open-ephys/ephys-test-module-molex-504070-32-chan/README.md

# Test Module for Molex 504070-based Headstages

This test module works with the Open Ephys
[automated ephys tester](https://github.com/open-ephys/ephys-test-board). 
It can be used to verify the functionality of:

- ONIX Neuropixels 2.0 & Biosignal Headstage
