open-ephys/ephys-test-module-molex-504070-32-chan/eeprom/README.md

## Module EEPROM Programmer
This program can be run on the ephys-test-board when the
module is in to program its EEPROM.
