open-ephys/ephys-test-module-molex-504070-32-chan/pcb/ephys-test-module-molex-504070-32.kicad_pcb

## KiCad design pcb/ephys-test-module-molex-504070-32.kicad_pcb (2026-01-21)

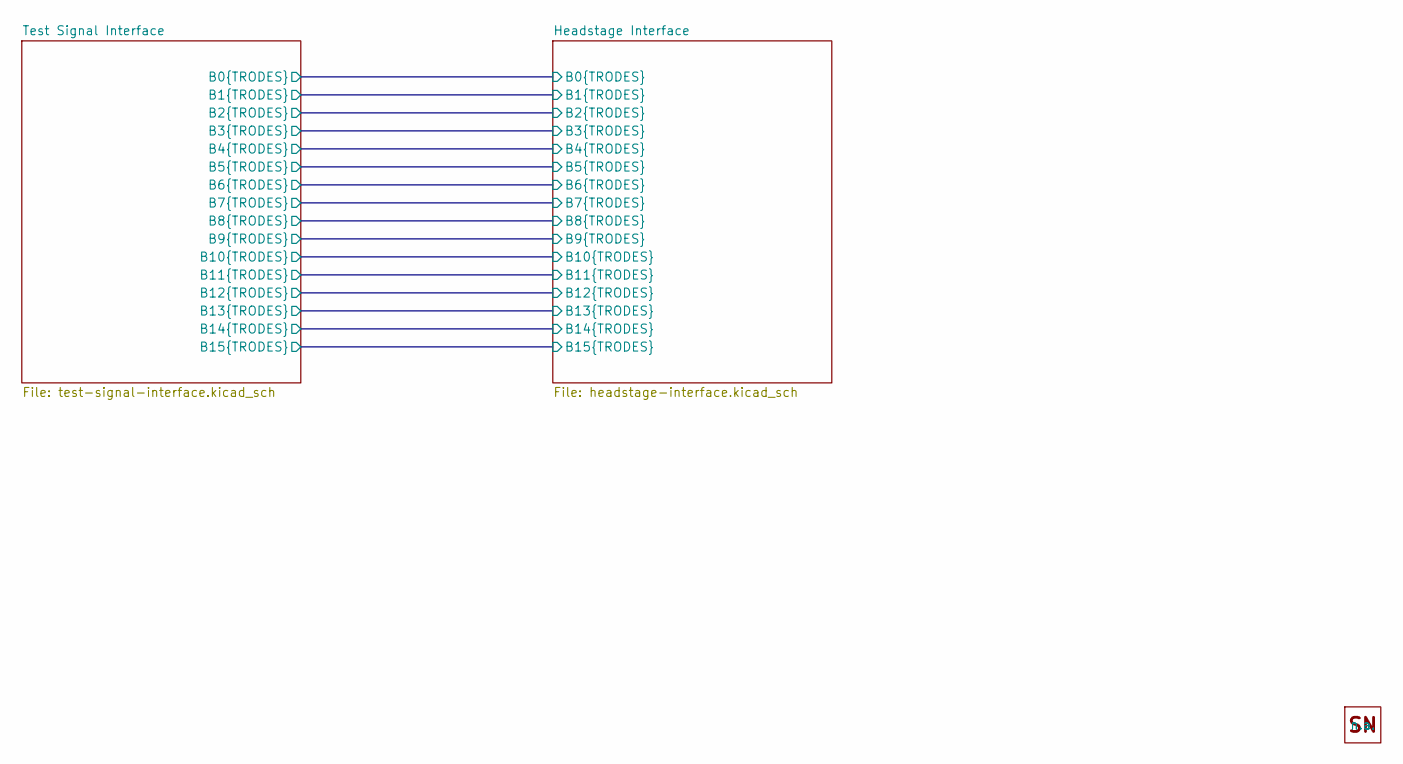
[picture p1: schematic ephys-test-module-molex-504070-32.kicad_sch, Ephys Test Module - 32 Channel (Molex 504070)]

Parts:
H1: OEPS_SN-STICKER-8x20mm; MPN n.a.

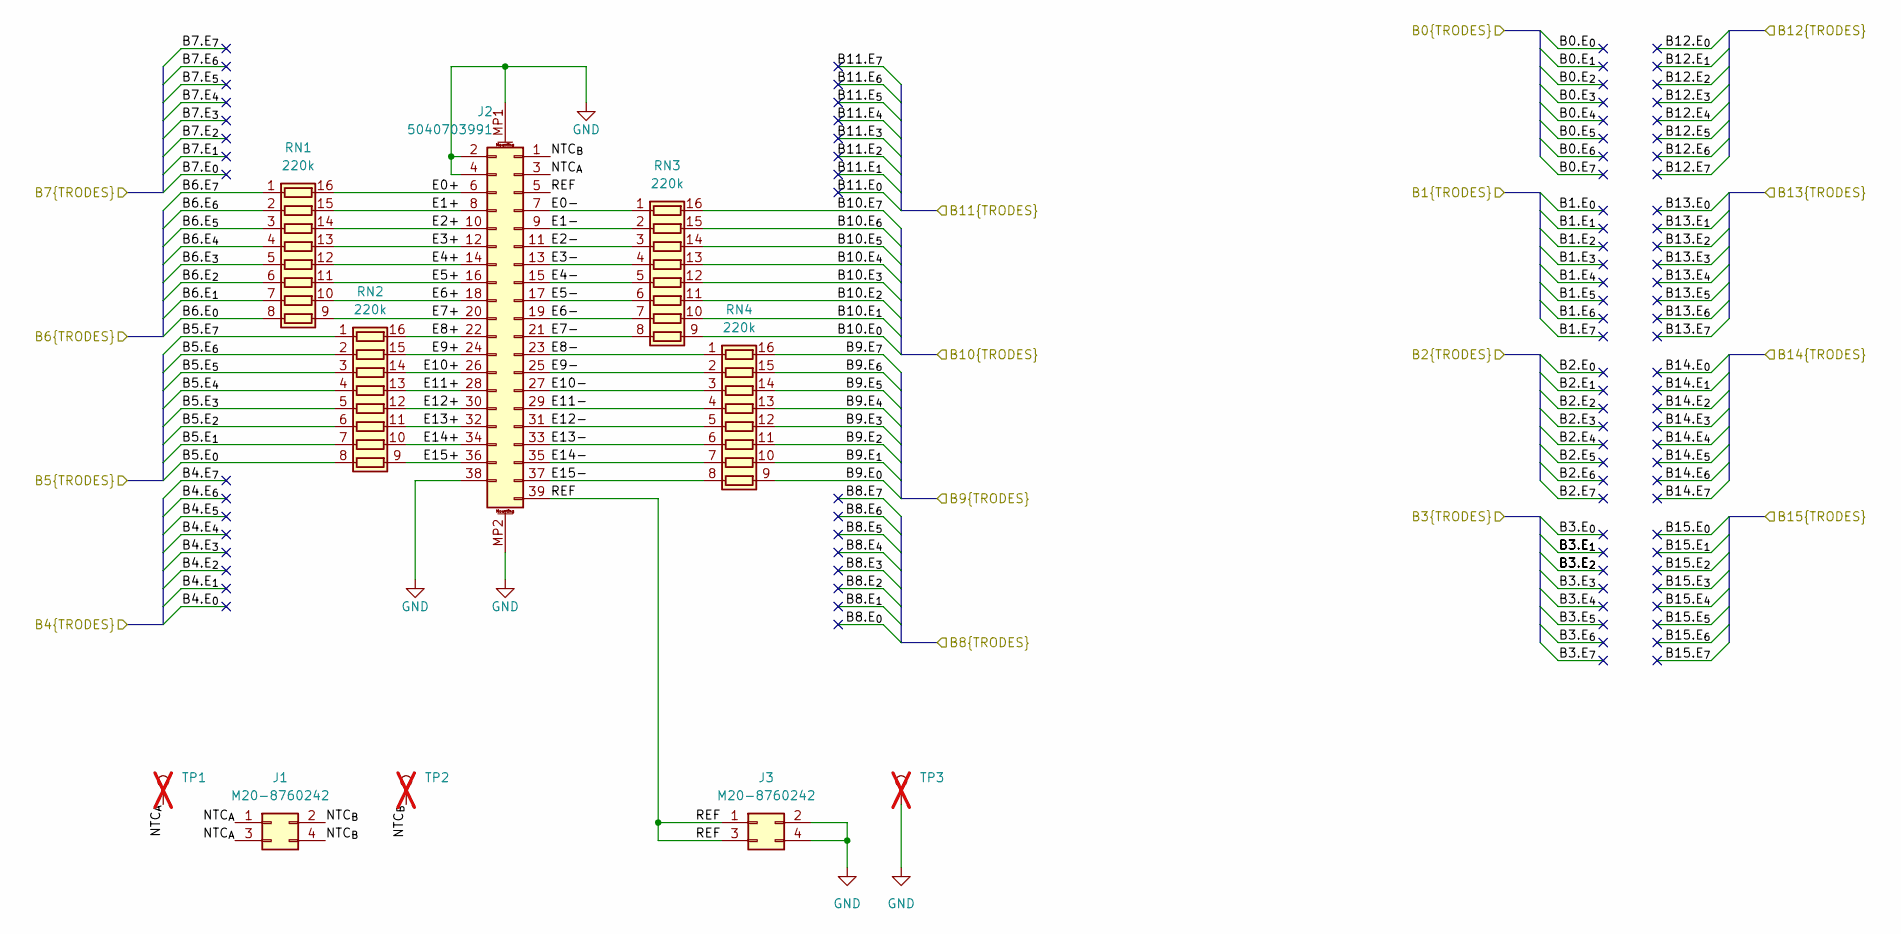
[picture p2: schematic headstage-interface.kicad_sch, Ephys Test Module - 32 Channel (Molex 504070)]

Parts:
J1, J3: M20-8760242; PinHeader_2x02_P2.54mm_Vertical_SMD; MPN M20-8760242
J2: 5040703991; MOLEX_5040703991; MPN 5040703991
RN1, RN2, RN3, RN4: 220k; R_Array_Convex_8x0602; Tolerance 5%; MPN YC248-JR-07220KL
TP1: TestPoint; TestPoint_Loop_D3.80mm_Drill2.8mm; MPN n.a.; not fitted
TP2, TP3: TestPoint; TestPoint_Loop_D3.80mm_Drill2.8mm; not fitted

Connections:
/Headstage Interface/B5.E_{0}: RN2.8 (R8.1); also elsewhere on the board
/Headstage Interface/B5.E_{1}: RN2.7 (R7.1); also elsewhere on the board
/Headstage Interface/B5.E_{2}: RN2.6 (R6.1); also elsewhere on the board
/Headstage Interface/B5.E_{3}: RN2.5 (R5.1); also elsewhere on the board
/Headstage Interface/B5.E_{4}: RN2.4 (R4.1); also elsewhere on the board
/Headstage Interface/B5.E_{5}: RN2.3 (R3.1); also elsewhere on the board
/Headstage Interface/B5.E_{6}: RN2.2 (R2.1); also elsewhere on the board
/Headstage Interface/B5.E_{7}: RN2.1 (R1.1); also elsewhere on the board
/Headstage Interface/B6.E_{0}: RN1.8 (R8.1); also elsewhere on the board
/Headstage Interface/B6.E_{1}: RN1.7 (R7.1); also elsewhere on the board
/Headstage Interface/B6.E_{2}: RN1.6 (R6.1); also elsewhere on the board
/Headstage Interface/B6.E_{3}: RN1.5 (R5.1); also elsewhere on the board
/Headstage Interface/B6.E_{4}: RN1.4 (R4.1); also elsewhere on the board
/Headstage Interface/B6.E_{5}: RN1.3 (R3.1); also elsewhere on the board
/Headstage Interface/B6.E_{6}: RN1.2 (R2.1); also elsewhere on the board
/Headstage Interface/B6.E_{7}: RN1.1 (R1.1); also elsewhere on the board
/Headstage Interface/B9.E_{0}: RN4.9 (R8.2); also elsewhere on the board
/Headstage Interface/B9.E_{1}: RN4.10 (R7.2); also elsewhere on the board
/Headstage Interface/B9.E_{2}: RN4.11 (R6.2); also elsewhere on the board
/Headstage Interface/B9.E_{3}: RN4.12 (R5.2); also elsewhere on the board
/Headstage Interface/B9.E_{4}: RN4.13 (R4.2); also elsewhere on the board
/Headstage Interface/B9.E_{5}: RN4.14 (R3.2); also elsewhere on the board
/Headstage Interface/B9.E_{6}: RN4.15 (R2.2); also elsewhere on the board
/Headstage Interface/B9.E_{7}: RN4.16 (R1.2); also elsewhere on the board
/Headstage Interface/B10.E_{0}: RN3.9 (R8.2); also elsewhere on the board
/Headstage Interface/B10.E_{1}: RN3.10 (R7.2); also elsewhere on the board
/Headstage Interface/B10.E_{2}: RN3.11 (R6.2); also elsewhere on the board
/Headstage Interface/B10.E_{3}: RN3.12 (R5.2); also elsewhere on the board
/Headstage Interface/B10.E_{4}: RN3.13 (R4.2); also elsewhere on the board
/Headstage Interface/B10.E_{5}: RN3.14 (R3.2); also elsewhere on the board
/Headstage Interface/B10.E_{6}: RN3.15 (R2.2); also elsewhere on the board
/Headstage Interface/B10.E_{7}: RN3.16 (R1.2); also elsewhere on the board
/Headstage Interface/E0+: J2.6, RN1.16 (R1.2)
/Headstage Interface/E0-: J2.7, RN3.1 (R1.1)
/Headstage Interface/E1+: J2.8, RN1.15 (R2.2)
/Headstage Interface/E1-: J2.9, RN3.2 (R2.1)
/Headstage Interface/E2+: J2.10, RN1.14 (R3.2)
/Headstage Interface/E2-: J2.11, RN3.3 (R3.1)
/Headstage Interface/E3+: J2.12, RN1.13 (R4.2)
/Headstage Interface/E3-: J2.13, RN3.4 (R4.1)
/Headstage Interface/E4+: J2.14, RN1.12 (R5.2)
/Headstage Interface/E4-: J2.15, RN3.5 (R5.1)
/Headstage Interface/E5+: J2.16, RN1.11 (R6.2)
/Headstage Interface/E5-: J2.17, RN3.6 (R6.1)
/Headstage Interface/E6+: J2.18, RN1.10 (R7.2)
/Headstage Interface/E6-: J2.19, RN3.7 (R7.1)
/Headstage Interface/E7+: J2.20, RN1.9 (R8.2)
/Headstage Interface/E7-: J2.21, RN3.8 (R8.1)
/Headstage Interface/E8+: J2.22, RN2.16 (R1.2)
/Headstage Interface/E8-: J2.23, RN4.1 (R1.1)
/Headstage Interface/E9+: J2.24, RN2.15 (R2.2)
/Headstage Interface/E9-: J2.25, RN4.2 (R2.1)
/Headstage Interface/E10+: J2.26, RN2.14 (R3.2)
/Headstage Interface/E10-: J2.27, RN4.3 (R3.1)
/Headstage Interface/E11+: J2.28, RN2.13 (R4.2)
/Headstage Interface/E11-: J2.29, RN4.4 (R4.1)
/Headstage Interface/E12+: J2.30, RN2.12 (R5.2)
/Headstage Interface/E12-: J2.31, RN4.5 (R5.1)
/Headstage Interface/E13+: J2.32, RN2.11 (R6.2)
/Headstage Interface/E13-: J2.33 (Pin_31), RN4.6 (R6.1)
/Headstage Interface/E14+: J2.34 (Pin_32), RN2.10 (R7.2)
/Headstage Interface/E14-: J2.35 (Pin_31), RN4.7 (R7.1)
/Headstage Interface/E15+: J2.36 (Pin_32), RN2.9 (R8.2)
/Headstage Interface/E15-: J2.37 (Pin_31), RN4.8 (R8.1)
/Headstage Interface/NTC_{A}: J1.1, J1.3, J2.3, TP1.1
/Headstage Interface/NTC_{B}: J1.2, J1.4, J2.1, TP2.1
/Headstage Interface/REF: J2.5, J2.39 (Pin_31), J3.1, J3.3
GND: J2.2, J2.4, J2.38 (Pin_32), J2.MP1 (MountPin1), J2.MP2 (MountPin2), J3.2, J3.4, TP3.1; also elsewhere on the board

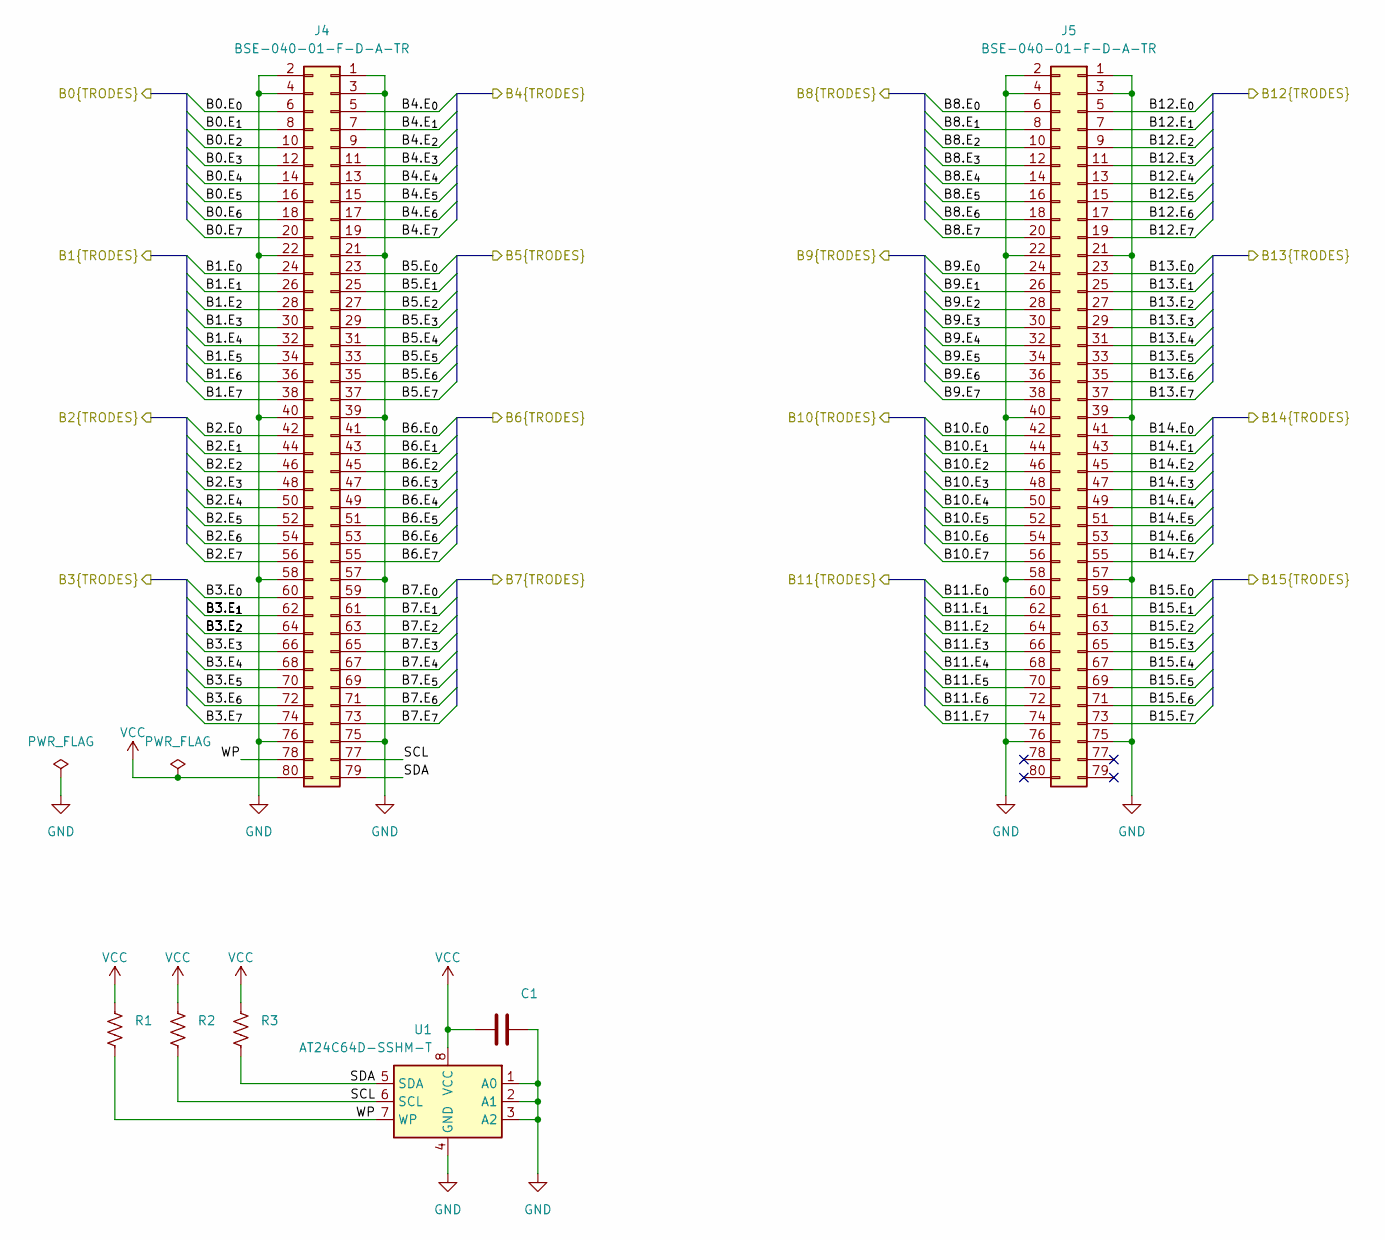
[picture p3: schematic test-signal-interface.kicad_sch, Ephys Test Module - 32 Channel (Molex 504070)]

Parts:
C1: 100nF; C_0402_1005Metric; Tolerance 10%; MPN C1005X5R1V104K050BB
J4, J5: BSE-040-01-F-D-A-TR; SAMTEC_BSE-040-01-X-D-A; MPN BSE-040-01-F-D-A-TR
R1, R2, R3: 1k; R_0402_1005Metric; Tolerance 1%; MPN CRCW04021K00FKED
U1: AT24C64D-SSHM-T; SOIC-8_3.9x4.9mm_P1.27mm; MPN AT24C64D-SSHM-T

Connections:
/Headstage Interface/B0.E_{0}: J4.6
/Headstage Interface/B0.E_{1}: J4.8
/Headstage Interface/B0.E_{2}: J4.10
/Headstage Interface/B0.E_{3}: J4.12
/Headstage Interface/B0.E_{4}: J4.14
/Headstage Interface/B0.E_{5}: J4.16
/Headstage Interface/B0.E_{6}: J4.18
/Headstage Interface/B0.E_{7}: J4.20
/Headstage Interface/B1.E_{0}: J4.24
/Headstage Interface/B1.E_{1}: J4.26
/Headstage Interface/B1.E_{2}: J4.28
/Headstage Interface/B1.E_{3}: J4.30
/Headstage Interface/B1.E_{4}: J4.32
/Headstage Interface/B1.E_{5}: J4.34
/Headstage Interface/B1.E_{6}: J4.36
/Headstage Interface/B1.E_{7}: J4.38
/Headstage Interface/B2.E_{0}: J4.42
/Headstage Interface/B2.E_{1}: J4.44
/Headstage Interface/B2.E_{2}: J4.46
/Headstage Interface/B2.E_{3}: J4.48
/Headstage Interface/B2.E_{4}: J4.50
/Headstage Interface/B2.E_{5}: J4.52
/Headstage Interface/B2.E_{6}: J4.54
/Headstage Interface/B2.E_{7}: J4.56
/Headstage Interface/B3.E_{0}: J4.60
/Headstage Interface/B3.E_{1}: J4.62
/Headstage Interface/B3.E_{2}: J4.64
/Headstage Interface/B3.E_{3}: J4.66
/Headstage Interface/B3.E_{4}: J4.68
/Headstage Interface/B3.E_{5}: J4.70
/Headstage Interface/B3.E_{6}: J4.72
/Headstage Interface/B3.E_{7}: J4.74
/Headstage Interface/B4.E_{0}: J4.5
/Headstage Interface/B4.E_{1}: J4.7
/Headstage Interface/B4.E_{2}: J4.9
/Headstage Interface/B4.E_{3}: J4.11
/Headstage Interface/B4.E_{4}: J4.13
/Headstage Interface/B4.E_{5}: J4.15
/Headstage Interface/B4.E_{6}: J4.17
/Headstage Interface/B4.E_{7}: J4.19
/Headstage Interface/B5.E_{0}: J4.23; also elsewhere on the board
/Headstage Interface/B5.E_{1}: J4.25; also elsewhere on the board
/Headstage Interface/B5.E_{2}: J4.27; also elsewhere on the board
/Headstage Interface/B5.E_{3}: J4.29; also elsewhere on the board
/Headstage Interface/B5.E_{4}: J4.31; also elsewhere on the board
/Headstage Interface/B5.E_{5}: J4.33; also elsewhere on the board
/Headstage Interface/B5.E_{6}: J4.35; also elsewhere on the board
/Headstage Interface/B5.E_{7}: J4.37; also elsewhere on the board
/Headstage Interface/B6.E_{0}: J4.41; also elsewhere on the board
/Headstage Interface/B6.E_{1}: J4.43; also elsewhere on the board
/Headstage Interface/B6.E_{2}: J4.45; also elsewhere on the board
/Headstage Interface/B6.E_{3}: J4.47; also elsewhere on the board
/Headstage Interface/B6.E_{4}: J4.49; also elsewhere on the board
/Headstage Interface/B6.E_{5}: J4.51; also elsewhere on the board
/Headstage Interface/B6.E_{6}: J4.53; also elsewhere on the board
/Headstage Interface/B6.E_{7}: J4.55; also elsewhere on the board
/Headstage Interface/B7.E_{0}: J4.59
/Headstage Interface/B7.E_{1}: J4.61
/Headstage Interface/B7.E_{2}: J4.63
/Headstage Interface/B7.E_{3}: J4.65
/Headstage Interface/B7.E_{4}: J4.67
/Headstage Interface/B7.E_{5}: J4.69
/Headstage Interface/B7.E_{6}: J4.71
/Headstage Interface/B7.E_{7}: J4.73
/Headstage Interface/B8.E_{0}: J5.6
/Headstage Interface/B8.E_{1}: J5.8
/Headstage Interface/B8.E_{2}: J5.10
/Headstage Interface/B8.E_{3}: J5.12
/Headstage Interface/B8.E_{4}: J5.14
/Headstage Interface/B8.E_{5}: J5.16
/Headstage Interface/B8.E_{6}: J5.18
/Headstage Interface/B8.E_{7}: J5.20
/Headstage Interface/B9.E_{0}: J5.24; also elsewhere on the board
/Headstage Interface/B9.E_{1}: J5.26; also elsewhere on the board
/Headstage Interface/B9.E_{2}: J5.28; also elsewhere on the board
/Headstage Interface/B9.E_{3}: J5.30; also elsewhere on the board
/Headstage Interface/B9.E_{4}: J5.32; also elsewhere on the board
/Headstage Interface/B9.E_{5}: J5.34; also elsewhere on the board
/Headstage Interface/B9.E_{6}: J5.36; also elsewhere on the board
/Headstage Interface/B9.E_{7}: J5.38; also elsewhere on the board
/Headstage Interface/B10.E_{0}: J5.42; also elsewhere on the board
/Headstage Interface/B10.E_{1}: J5.44; also elsewhere on the board
/Headstage Interface/B10.E_{2}: J5.46; also elsewhere on the board
/Headstage Interface/B10.E_{3}: J5.48; also elsewhere on the board
/Headstage Interface/B10.E_{4}: J5.50; also elsewhere on the board
/Headstage Interface/B10.E_{5}: J5.52; also elsewhere on the board
/Headstage Interface/B10.E_{6}: J5.54; also elsewhere on the board
/Headstage Interface/B10.E_{7}: J5.56; also elsewhere on the board
/Headstage Interface/B11.E_{0}: J5.60
/Headstage Interface/B11.E_{1}: J5.62
/Headstage Interface/B11.E_{2}: J5.64
/Headstage Interface/B11.E_{3}: J5.66
/Headstage Interface/B11.E_{4}: J5.68
/Headstage Interface/B11.E_{5}: J5.70
/Headstage Interface/B11.E_{6}: J5.72
/Headstage Interface/B11.E_{7}: J5.74
/Headstage Interface/B12.E_{0}: J5.5
/Headstage Interface/B12.E_{1}: J5.7
/Headstage Interface/B12.E_{2}: J5.9
/Headstage Interface/B12.E_{3}: J5.11
/Headstage Interface/B12.E_{4}: J5.13
/Headstage Interface/B12.E_{5}: J5.15
/Headstage Interface/B12.E_{6}: J5.17
/Headstage Interface/B12.E_{7}: J5.19
/Headstage Interface/B13.E_{0}: J5.23
/Headstage Interface/B13.E_{1}: J5.25
/Headstage Interface/B13.E_{2}: J5.27
/Headstage Interface/B13.E_{3}: J5.29
/Headstage Interface/B13.E_{4}: J5.31
/Headstage Interface/B13.E_{5}: J5.33
/Headstage Interface/B13.E_{6}: J5.35
/Headstage Interface/B13.E_{7}: J5.37
/Headstage Interface/B14.E_{0}: J5.41
/Headstage Interface/B14.E_{1}: J5.43
/Headstage Interface/B14.E_{2}: J5.45
/Headstage Interface/B14.E_{3}: J5.47
/Headstage Interface/B14.E_{4}: J5.49
/Headstage Interface/B14.E_{5}: J5.51
/Headstage Interface/B14.E_{6}: J5.53
/Headstage Interface/B14.E_{7}: J5.55
/Headstage Interface/B15.E_{0}: J5.59
/Headstage Interface/B15.E_{1}: J5.61
/Headstage Interface/B15.E_{2}: J5.63
/Headstage Interface/B15.E_{3}: J5.65
/Headstage Interface/B15.E_{4}: J5.67
/Headstage Interface/B15.E_{5}: J5.69
/Headstage Interface/B15.E_{6}: J5.71
/Headstage Interface/B15.E_{7}: J5.73
/Test Signal Interface/SCL: J4.77, R2.2, U1.6 (SCL)
/Test Signal Interface/SDA: J4.79, R3.2, U1.5 (SDA)
/Test Signal Interface/WP: J4.78, R1.2, U1.7 (WP)
GND: C1.2, J4.1, J4.2, J4.3, J4.4, J4.21, J4.22, J4.39, J4.40, J4.57, J4.58, J4.75, J4.76, J5.1, J5.2, J5.3, J5.4, J5.21, J5.22, J5.39, J5.40, J5.57, J5.58, J5.75, J5.76, U1.1 (A0), U1.2 (A1), U1.3 (A2), U1.4 (GND); also elsewhere on the board
VCC: C1.1, J4.80, R1.1, R2.1, R3.1, U1.8 (VCC)

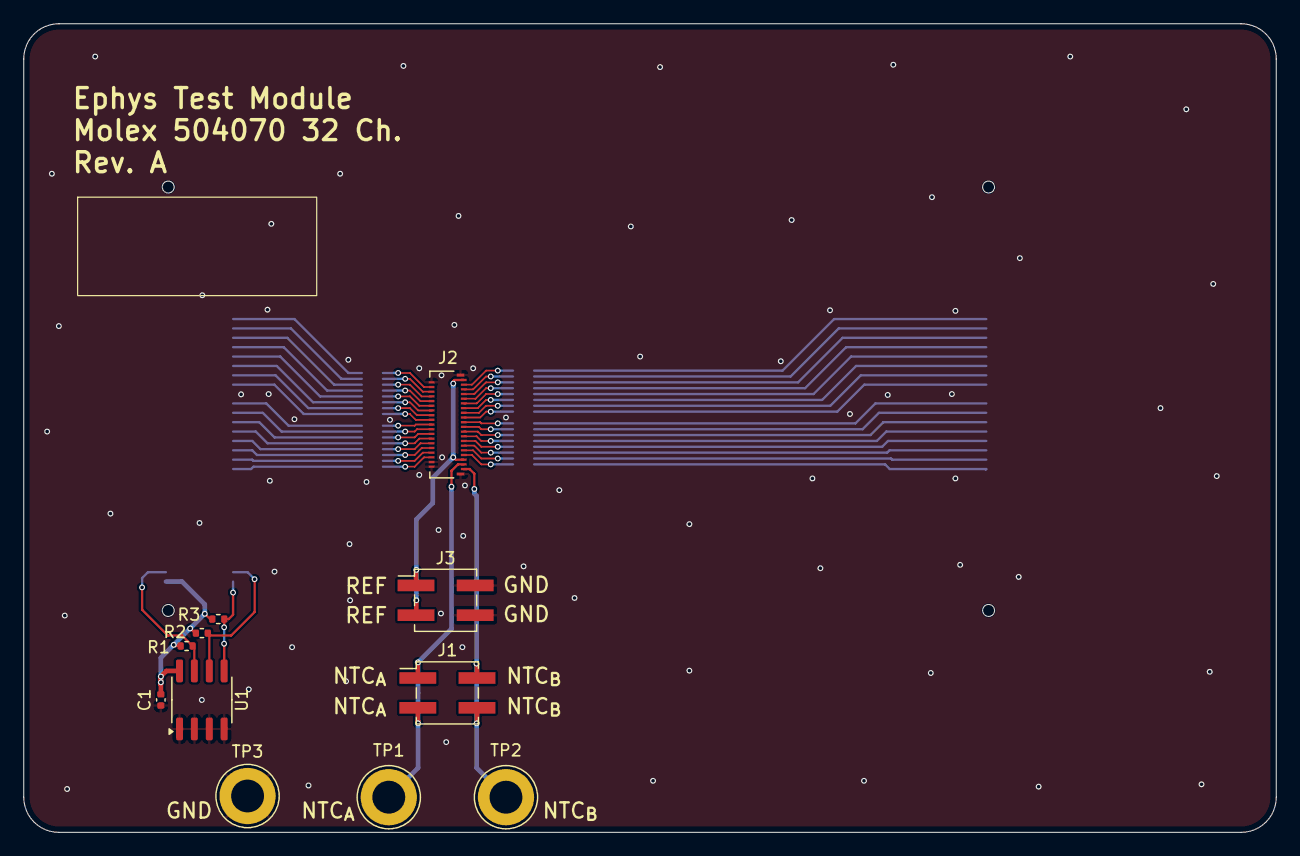
[picture p4: board ephys-test-module-molex-504070-32.kicad_pcb from above]

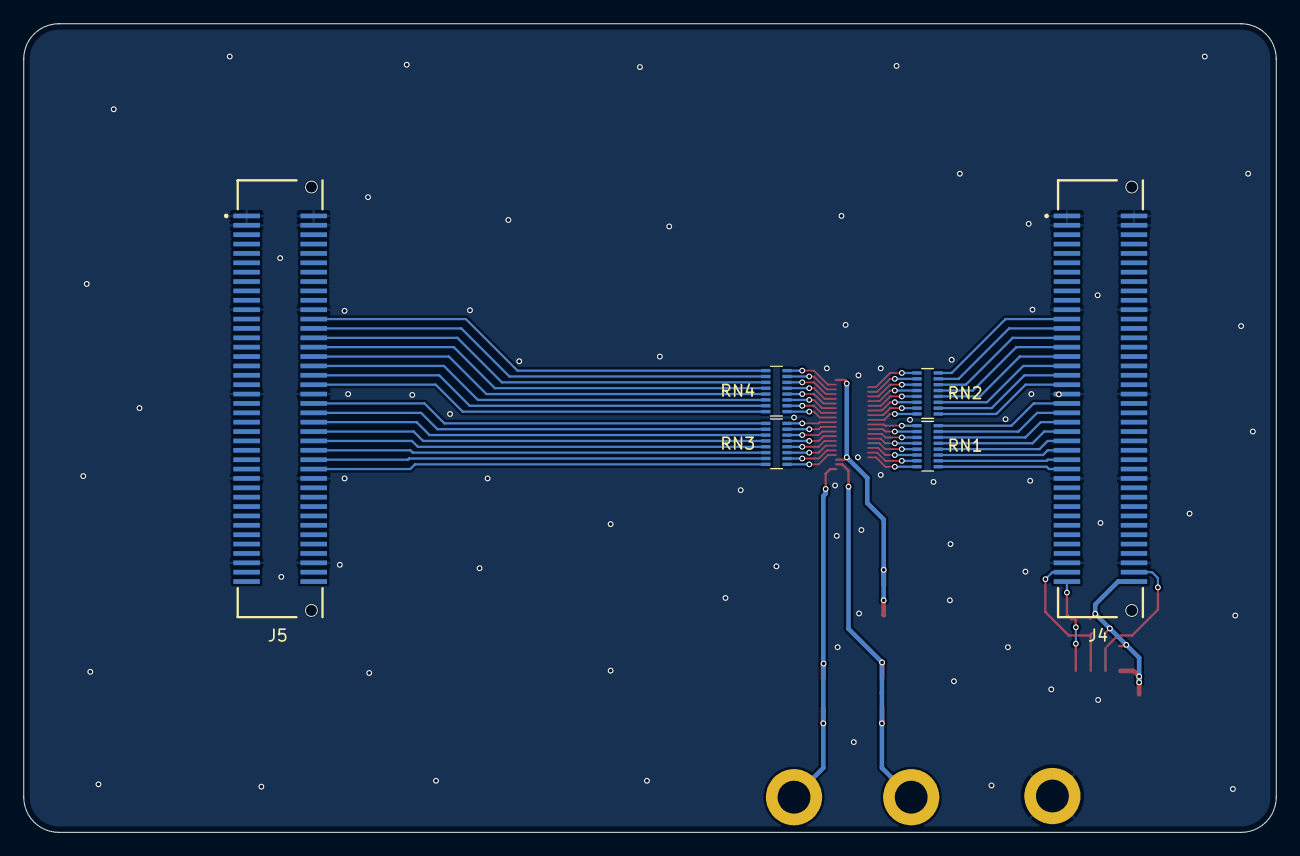
[picture p5: board ephys-test-module-molex-504070-32.kicad_pcb from below]

Board: 2 copper layers, 106.9 x 69.0 mm, 18 parts (6 on the bottom side), 72 nets.
