open-ephys/ephys-test-module-molex-504070-32-chan/fpc/molex-504070-fpc.kicad_pcb

## KiCad design fpc/molex-504070-fpc.kicad_pcb (2026-01-21)

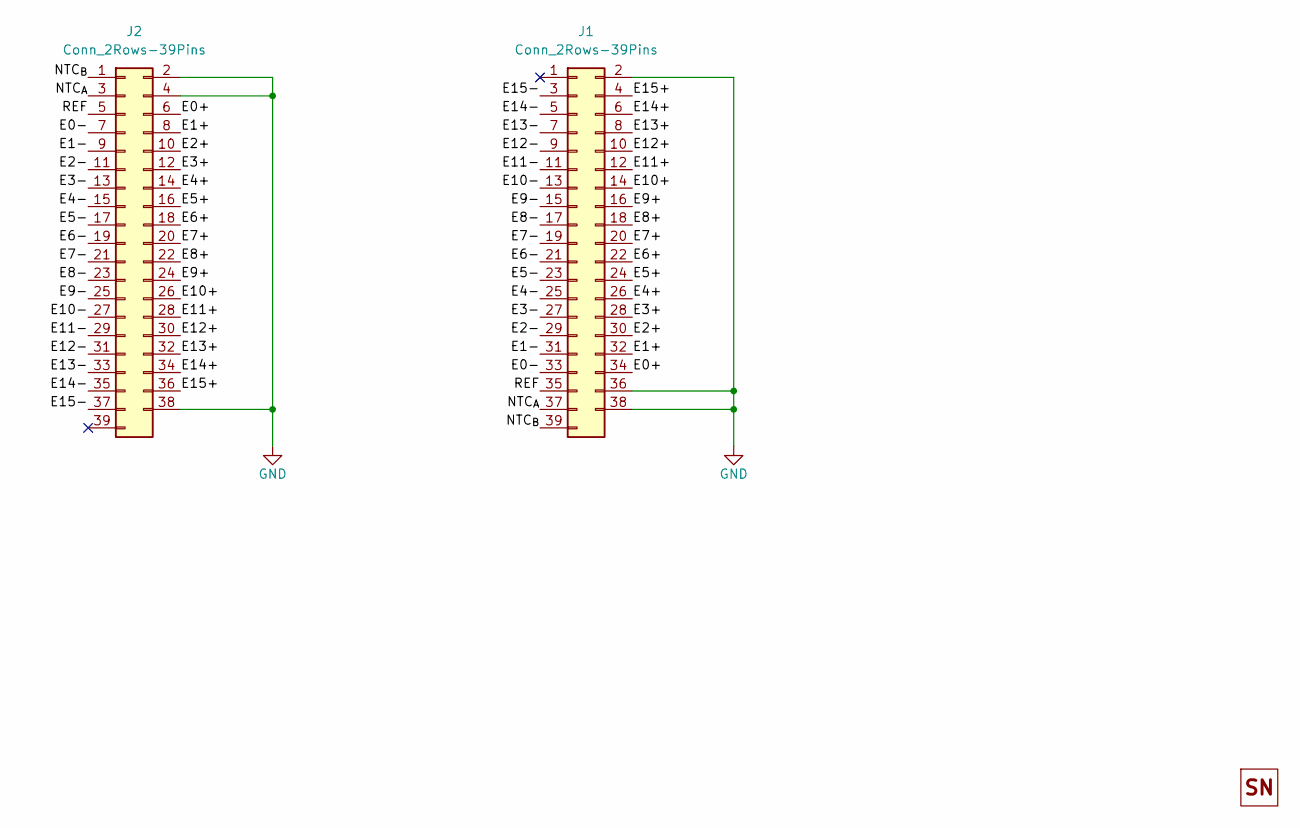
[picture p6: schematic molex-504070-fpc.kicad_sch, Molex 504070 FPC]

Parts:
H1: OEPS_SN-STICKER-5x5mm; MPN n.a.
J1, J2: Conn_2Rows-39Pins; MOLEX_5040703991_FPC-mate_low-spec

Connections:
/E0+: J1.34, J2.6
/E0-: J1.33, J2.7
/E1+: J1.32, J2.8
/E1-: J1.31, J2.9
/E2+: J1.30, J2.10
/E2-: J1.29, J2.11
/E3+: J1.28, J2.12
/E3-: J1.27, J2.13
/E4+: J1.26, J2.14
/E4-: J1.25, J2.15
/E5+: J1.24, J2.16
/E5-: J1.23, J2.17
/E6+: J1.22, J2.18
/E6-: J1.21, J2.19
/E7+: J1.20, J2.20
/E7-: J1.19, J2.21
/E8+: J1.18, J2.22
/E8-: J1.17, J2.23
/E9+: J1.16, J2.24
/E9-: J1.15, J2.25
/E10+: J1.14, J2.26
/E10-: J1.13, J2.27
/E11+: J1.12, J2.28
/E11-: J1.11, J2.29
/E12+: J1.10, J2.30
/E12-: J1.9, J2.31
/E13+: J1.8, J2.32
/E13-: J1.7, J2.33
/E14+: J1.6, J2.34
/E14-: J1.5, J2.35
/E15+: J1.4, J2.36
/E15-: J1.3, J2.37
/NTC_{A}: J1.37, J2.3
/NTC_{B}: J1.39, J2.1
/REF: J1.35, J2.5
GND: J1.2, J1.36, J1.38, J2.2, J2.4, J2.38

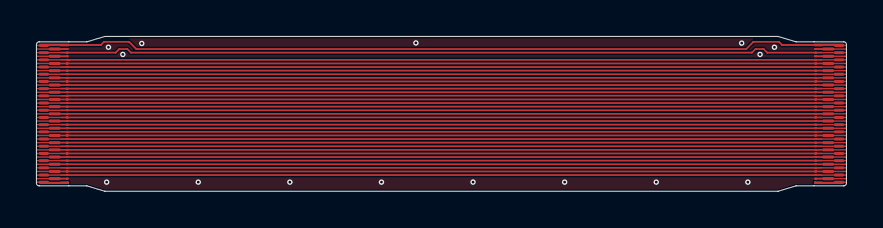
[picture p7: board molex-504070-fpc.kicad_pcb from above]

Board: 2 copper layers, 45.0 x 8.6 mm, 3 parts (0 on the bottom side), 36 nets.
