open-ephys/ephys-test-module-molex-504070-32-chan/(commit log)

2026-01-13 Update README
    - Fix connector name
2026-01-21 Revision A candidate
    - Also, added an mating FPC design to connect the test module to the
    headstage
    [ephys-test-module-molex-504070-32-B_Cu.gbr, ephys-test-module-molex-504070-32-B_Fab.gbr, ephys-test-module-molex-504070-32-B_Mask.gbr, ephys-test-module-molex-504070-32-B_Paste.gbr, ephys-test-module-molex-504070-32-B_Silkscreen.gbr, ephys-test-module-molex-504070-32-Edge_Cuts.gbr, ephys-test-module-molex-504070-32-F_Cu.gbr, ephys-test-module-molex-504070-32-F_Fab.gbr]
